dvisser-zz/Nissan-RB25DET-ECU/README.md

Nissan-RB25DET-ECU
==================

A drop in replacement PCB, designed to fit inside the factory ECU enclosure and use the factory wiring harness.
