dvisser-zz/Nissan-RB25DET-ECU/R33 RB25DET ECU Connector Pinout.pdf

R33 RB25DET ECU Pinout

Pin | Pin Function | Pin | Pin Function
| 1 IGN 1 | | 11 IGN 6
| 2 IGN 5 | | 12 IGN 2
| 3 IGN 3 | | 13 IGN 4
4 AAC Valve Control | 14
5 | 15
6 | 16 ECCS Relay
7 | 17
8 | 18 Fuel Pump Relay
| 9 A/C Relay | | 19 P/S Oil Pressure Switch
| 10 EARTH – IGN | | 20 EARTH – IGN
| 21 RX ( Diagnosis )* | | 31 CLK
| 22 TX ( Diagnosis )* | | 32 Engine Warning Lamp
23 | 33 Exhaust Temp Warning Lamp
24 | 34
25 Boost Control Solenoid | 35
| 26 AFM Signal Ground | | 36 FICD Relay
27 AFM Signal | 37
| 28 ECT Sensor Signal | | 38 TPS Signal
29 Oxygen Sensor Signal | 39
30 EARTH Sensor System | 40
| 41 CAS SYNC Signal | | 51 CAS SYNC Signal
42 CAS REF Signal | 52
| 43 Start Switch Signal | | 53 Vehicle Speed Sensor
44 Neutral Switch Signal* | 54
45 Ignition Switch Signal | 55
| 46 A/C Switch Signal | | 56 TPS Signal Out to A/T, HICAS
| 47 CHK ( Diagnosis )* | | 57 Exhaust Temp Sensor*
| 48 TPS Reference Voltage | | 58 Battery Power
| 49 C/U Power | | 59 C/U Power
| 50 C/U earth | | 60 C/U Earth
101 INJ 1 | 109 Inverse Current Feedback System
102 | | 110
103 INJ 3 | 111
104 Fuel Pump Speed Control | 112 INJ 6
105 INJ 2 | 113 VCT Solenoid
106 | 114 INJ 4
107 EARTH INJ System | 115 Oxygen Sensor Heater Ground
108 EARTH INJ System | 116 EARTH INJ System

* Not confirmed

Tacho Signal Out

Knock Sensor 1 ( Cyl 1-3 ) Knock Sensor 2 ( Cyl 4-6 )

INJ 5 (2nd)
