dvisser-zz/Nissan-RB25DET-ECU/76 Pin Connector 5-174385-5 .pdf

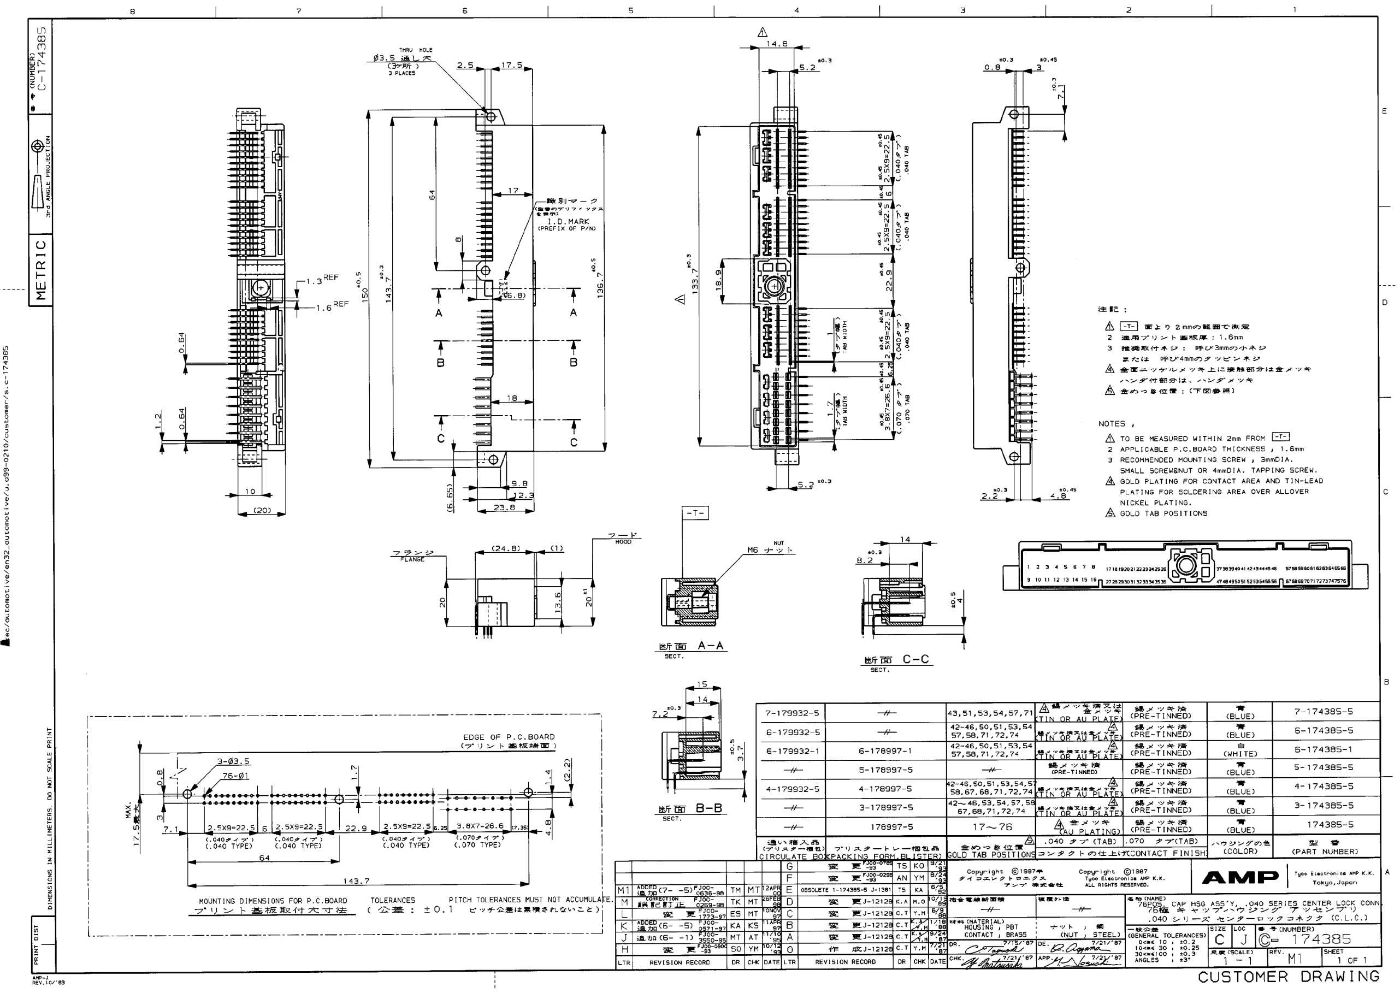
[picture p1: page 1]
