dvisser-zz/Nissan-RB25DET-ECU/Nissan-RB25DET-ECU-Connector.pdf

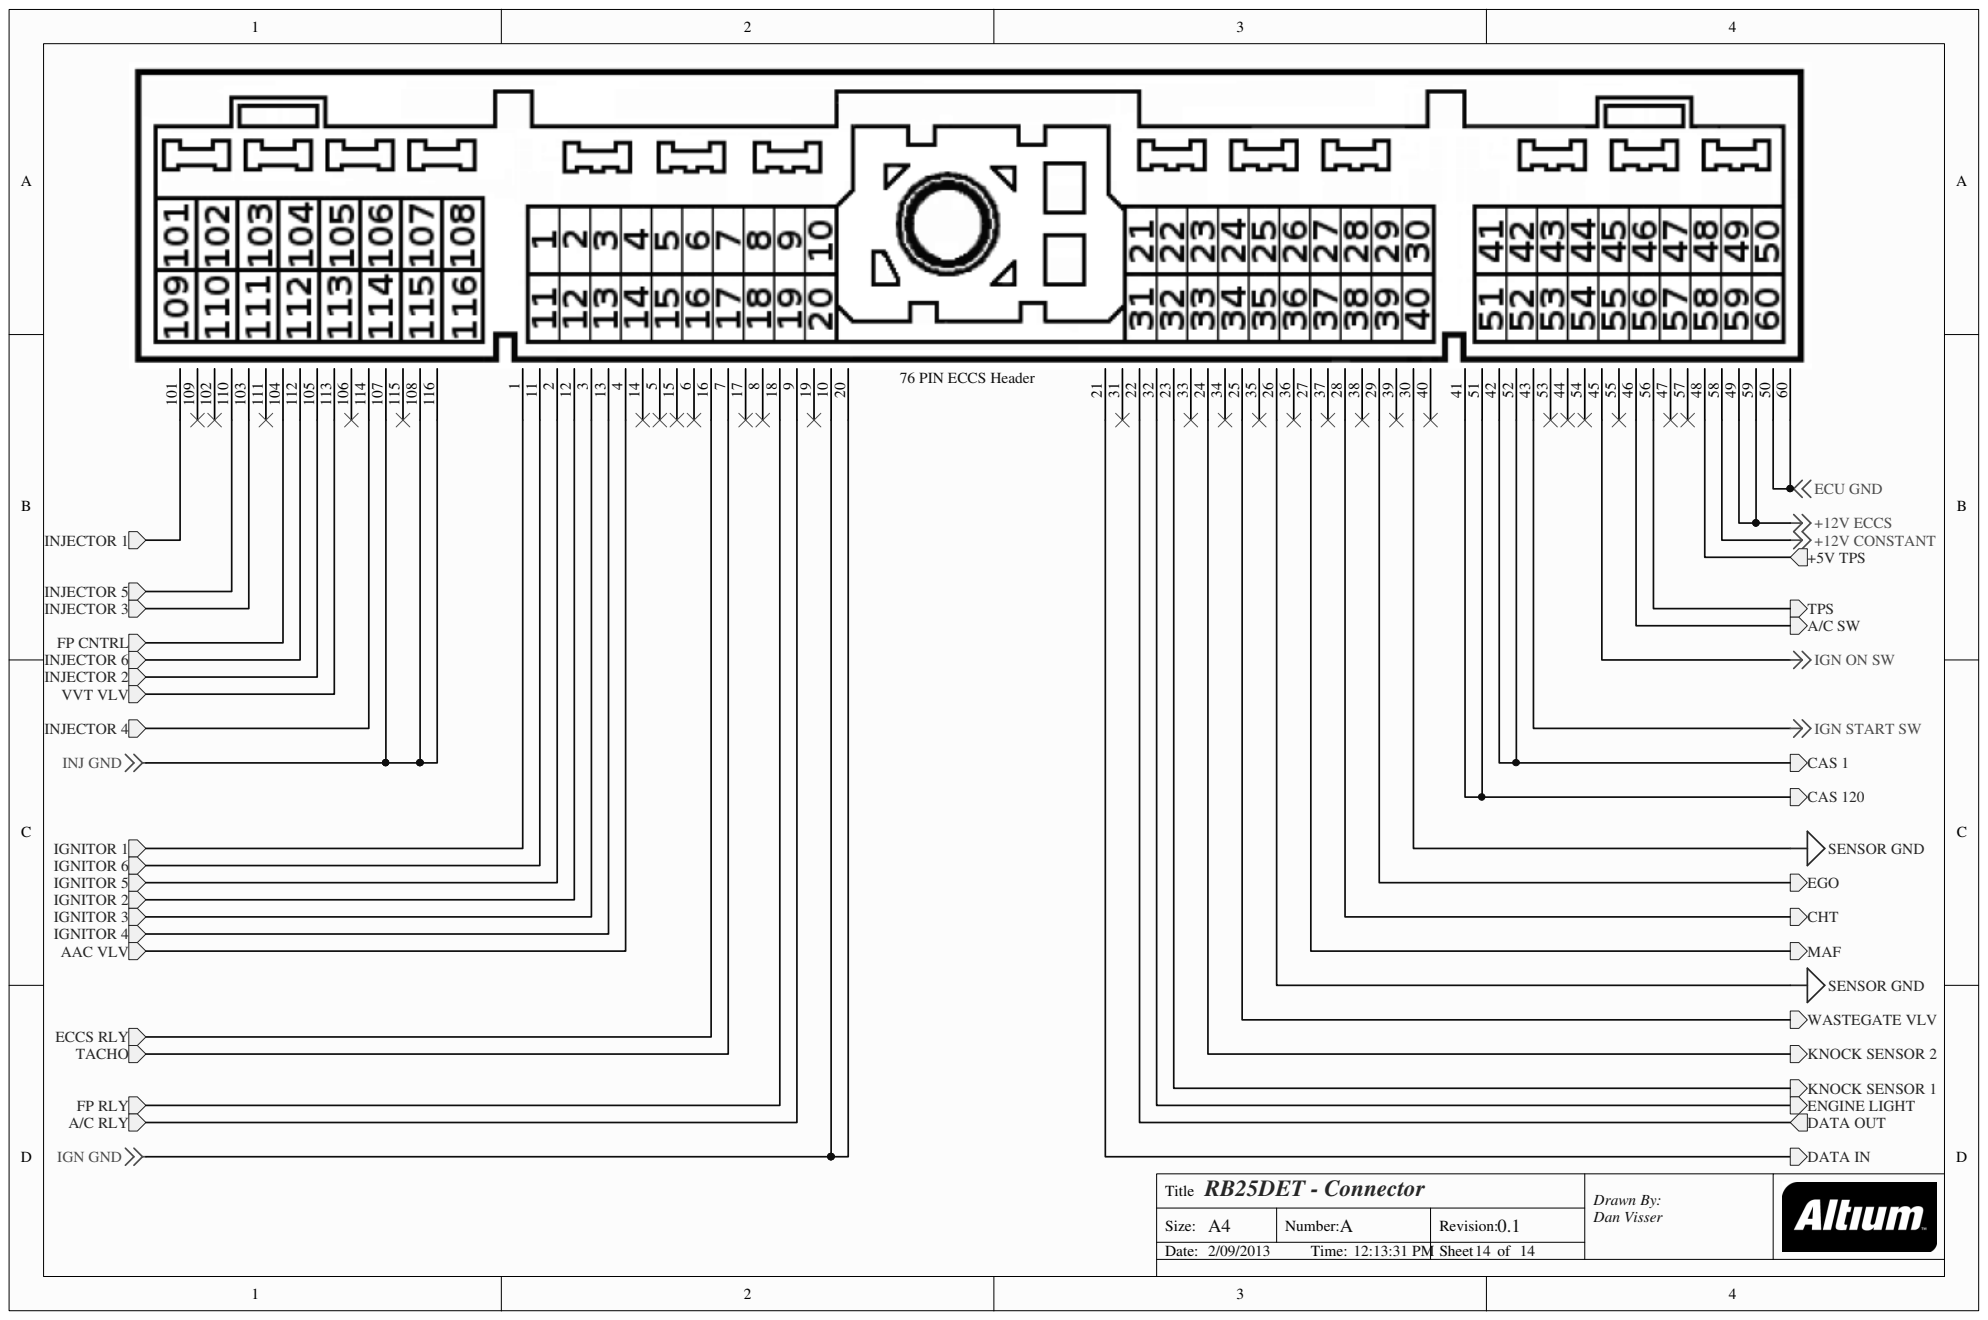
[picture p2: page 1]
Drawn By: Dan Visser; RB25DET - Connector; Title; Size:; Number:; Date:; Revision:; Time:; Sheet; +12V CONSTANT; +12V ECCS; ECU GND; INJ GND; INJECTOR 1; INJECTOR 2; INJECTOR 3; INJECTOR 4; INJECTOR 5; INJECTOR 6; FP RLY; IGNITOR 1; CHT; TPS; EGO; +5V TPS; IGNITOR 2; IGNITOR 3; IGNITOR 4; IGNITOR 5; IGNITOR 6; KNOCK SENSOR 1; SENSOR GND; IGN GND; DATA IN; DATA OUT; KNOCK SENSOR 2; WASTEGATE VLV; MAF; ENGINE LIGHT; VVT VLV; FP CNTRL; AAC VLV; ECCS RLY; TACHO; A/C RLY; CAS 120; CAS 1

76 PIN ECCS Header

IGN ON SW

IGN START SW
