dvisser-zz/Nissan-RB25DET-ECU/Nissan-RB25DET-ECU.pdf

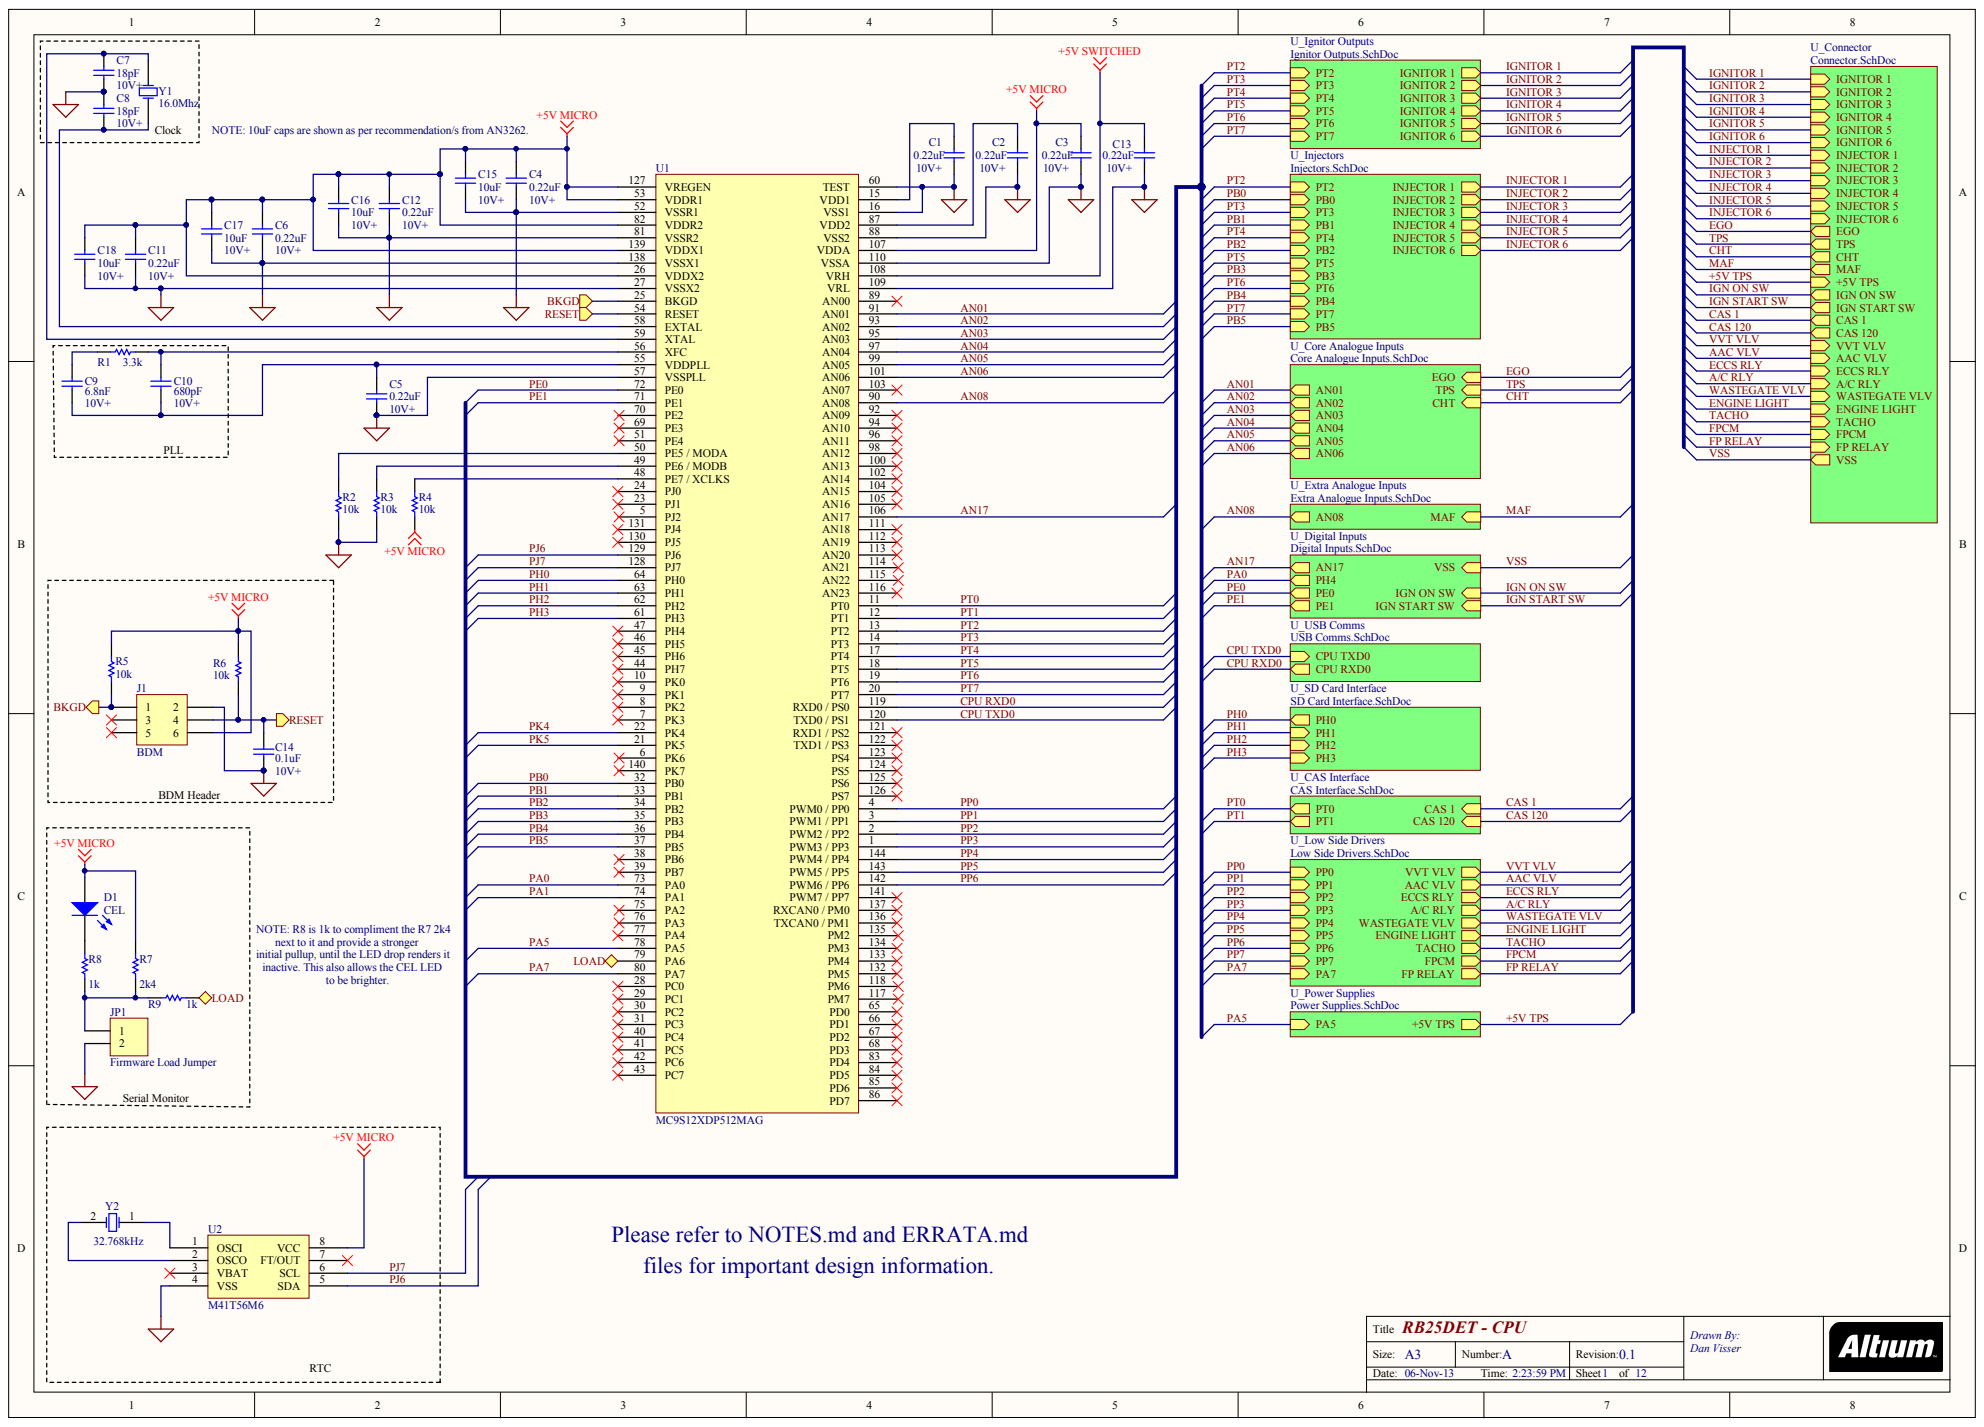
[picture p3: page 1]

IGNITOR 1 CHT TPS EGO
IGNITOR 1 CAS 1 CAS 120 CHT TPS EGO
IGNITOR 2
IGNITOR 3

5 2
8 2 | | 8 7

1 3 9 | 1 0 7
1 3 8 | | 1 1 0
2 6 | | 1 0 8

5 9
5 6 | U_ C ore An alo g u e Inp uts C ore An alo g u e Inp uts.S c hDo c
5 5

EGO TPS CHT CAS 1 CAS 1

WAS
TACHO ENGINE LIGHT FPCM

4 9 | | 1 0 0
4 8 | | 1 0 2

2 4 P J 6 | | 1 0 4 | U_ E xtra An alo g u e Inp uts E xtra An alo g u e Inp uts.S c hDo c

Please refer to NOTES.md and ERRATA.md
files for important design information.

Dr a w n By : Da n Vis s e r

A3 | er: | R e visio n :

Date : Time : | | S h e e t 1 o f 1 2

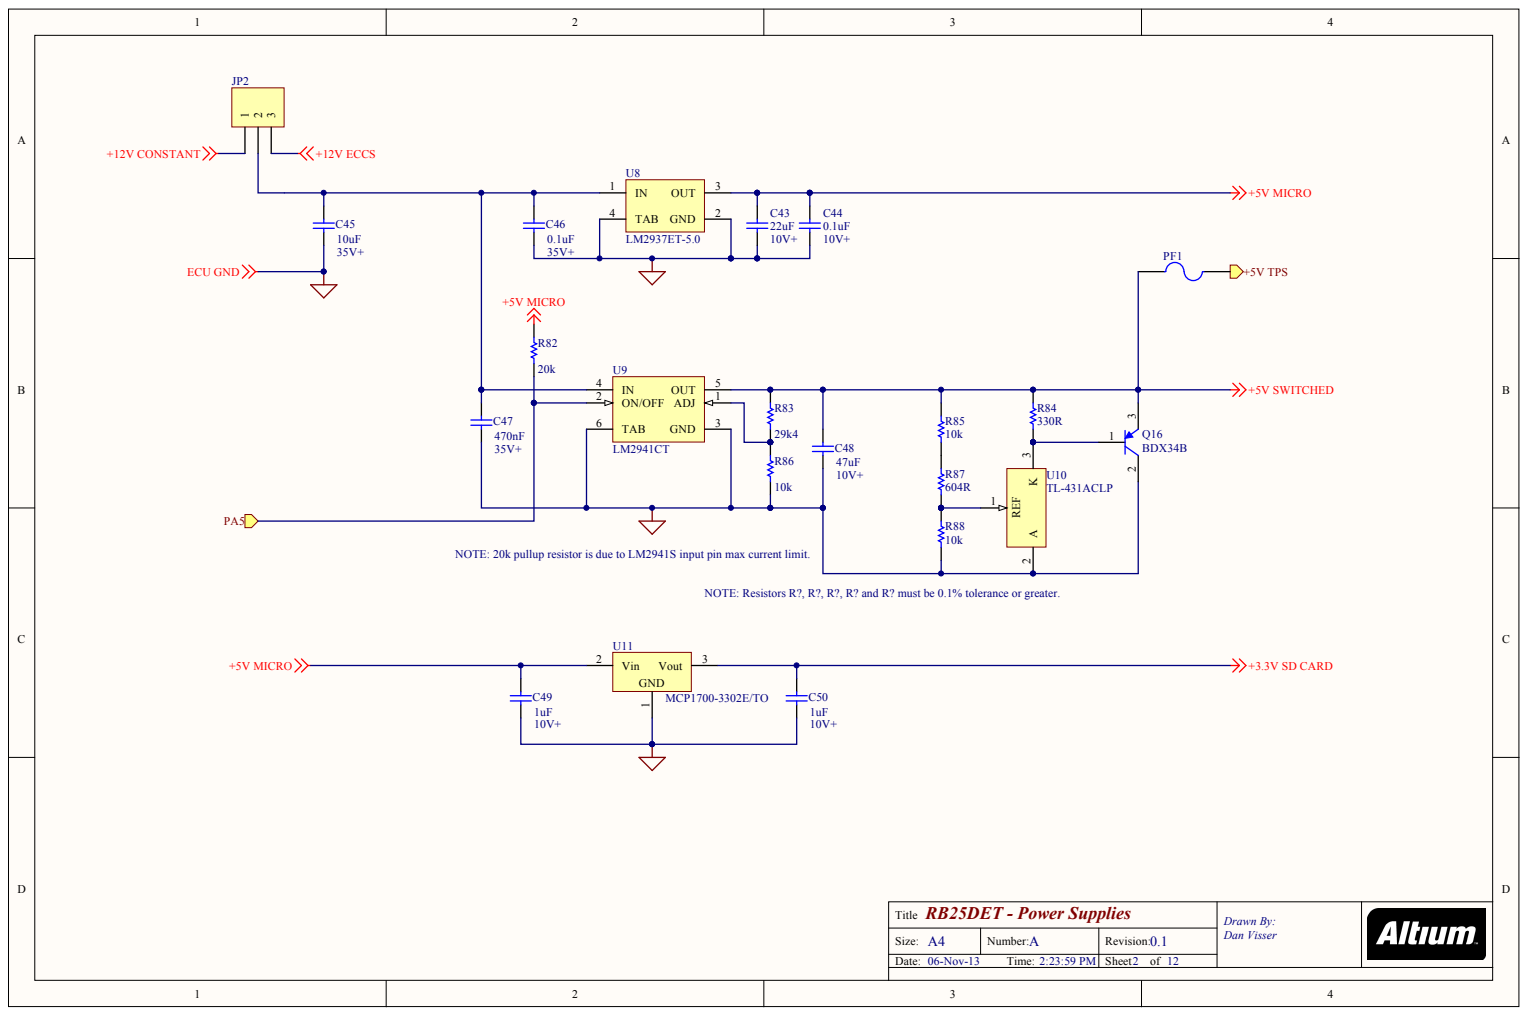
[picture p4: page 2]

p resistor is due to LM2

d R? must be 0.1% tolerance or greater.

Drawn By: Dan Visser

A4 | N umber: | Revisio n :
Date: Time: | | S heet 2 o f 1 2

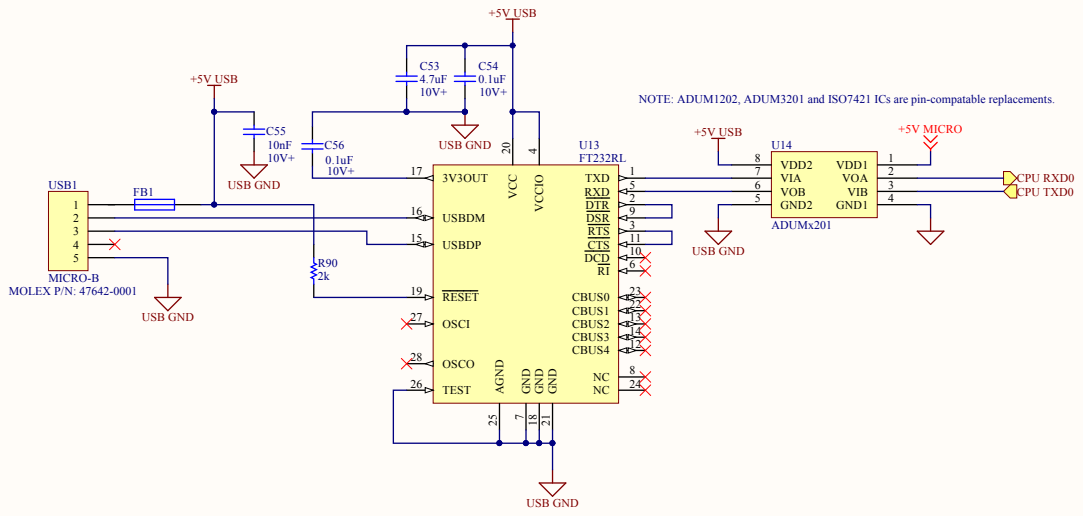
[picture p5: page 3]

1 ICs are pin-compatable replacements.

Drawn By: Dan Visser

A4 | N umber: | Revisio n :
Date: Time: | | S heet 3 o f 1 2

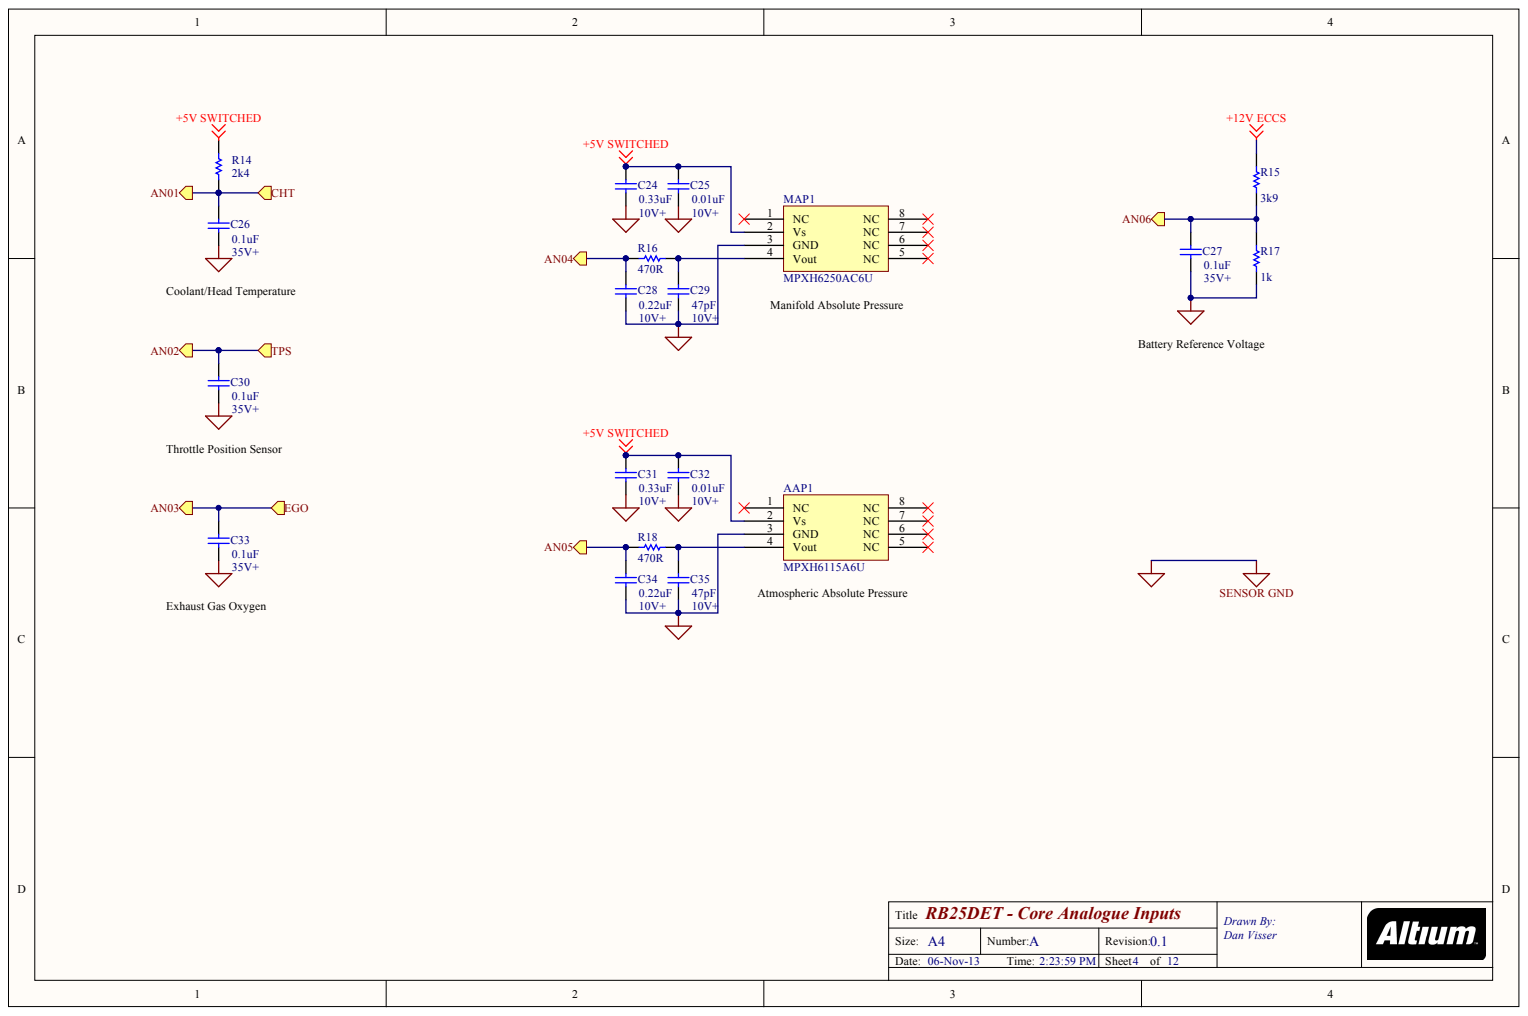
[picture p6: page 4]

Drawn By: Dan Visser

A4 | N umber: | Revisio n :
Date: Time: | | S heet 4 o f 1 2

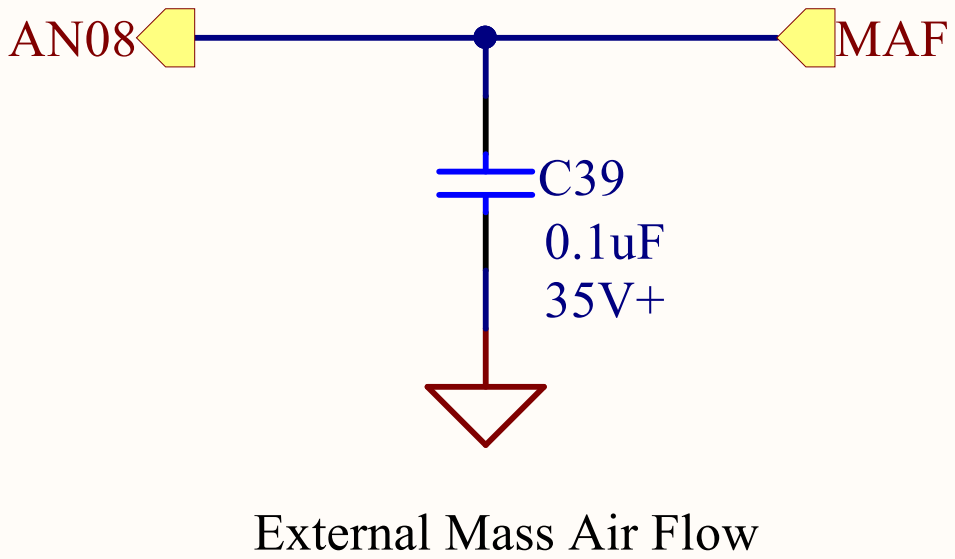
[picture p7: page 5]

External Mass Air Flo

Drawn By: Dan Visser

A4 | N umber: | Revisio n :
Date: Time: | | S heet 5 o f 1 2

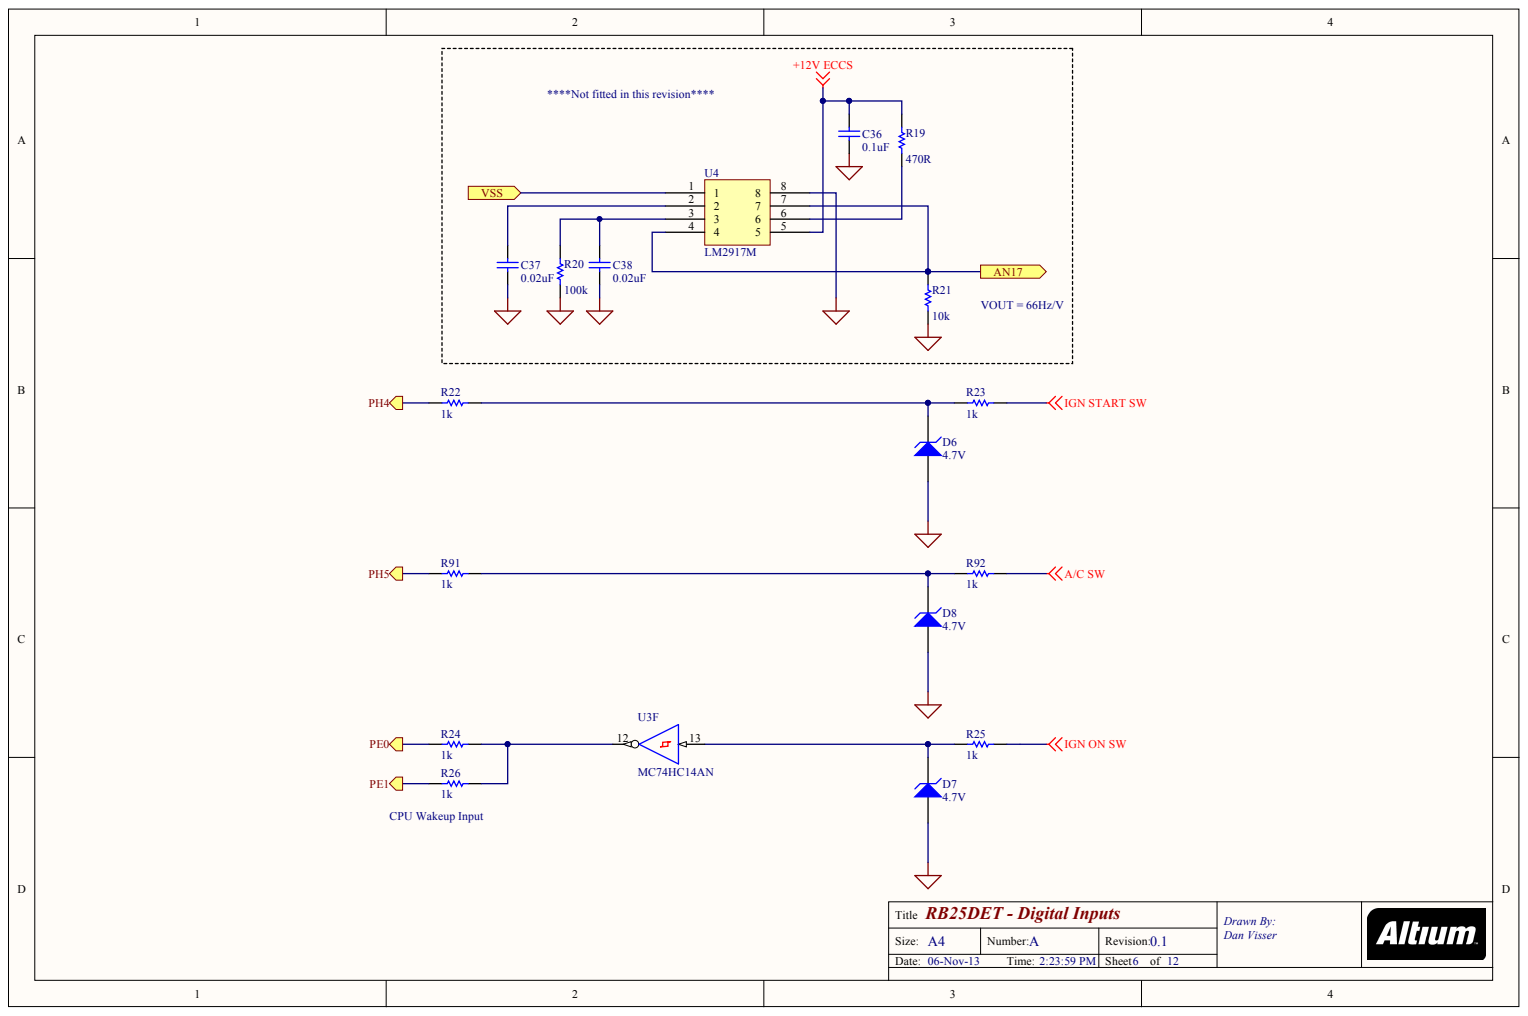
[picture p8: page 6]

****Not fitted in this revision****

Title RB25DET - Digital Inputs | Drawn By: Dan Visser

Size: A4 | Number: A | Revision: 0.1
Date: 06-Nov-13 Time: 2:23:59 PM | | Sheet 6 of 12

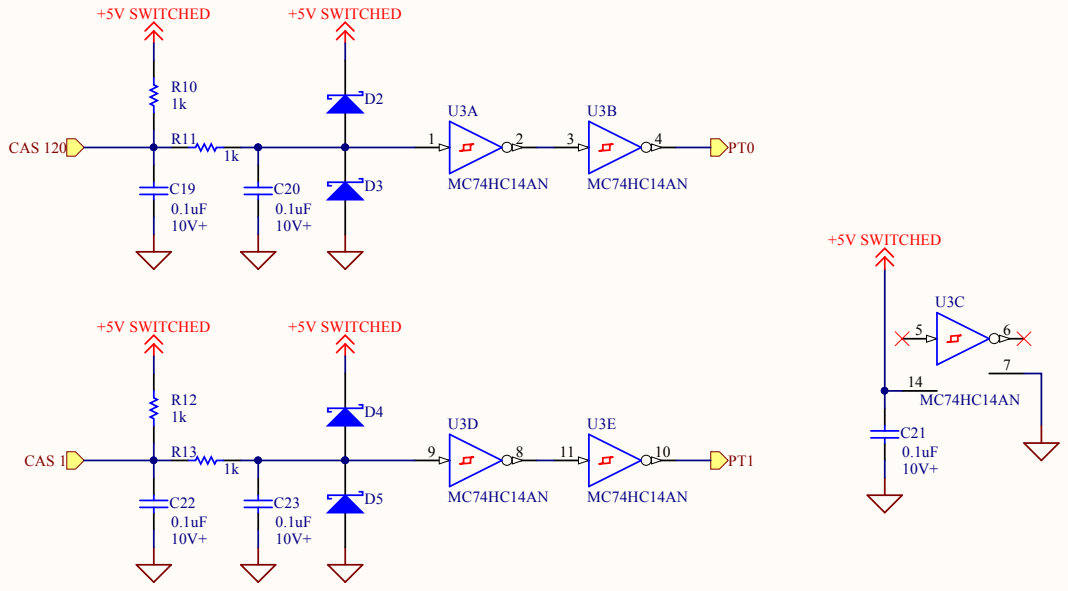
[picture p9: page 7]

Drawn By: Dan Visser

A4 | N umber: | Revisio n :
Date: Time: | | S heet 7 o f 1 2

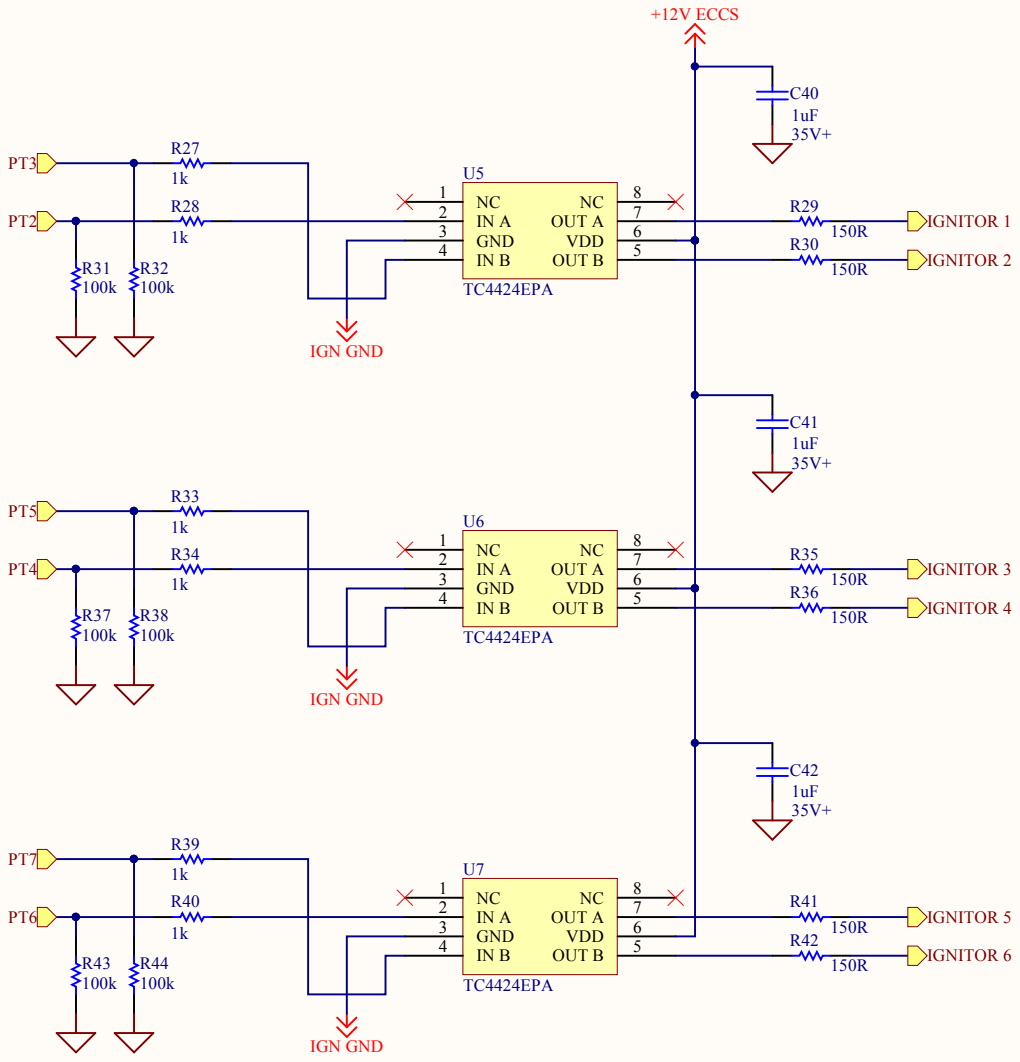
[picture p10: page 8]

Drawn By: Dan Visser

A4 | N umber: | Revisio n :
Date: Time: | | S heet 8 o f 1 2

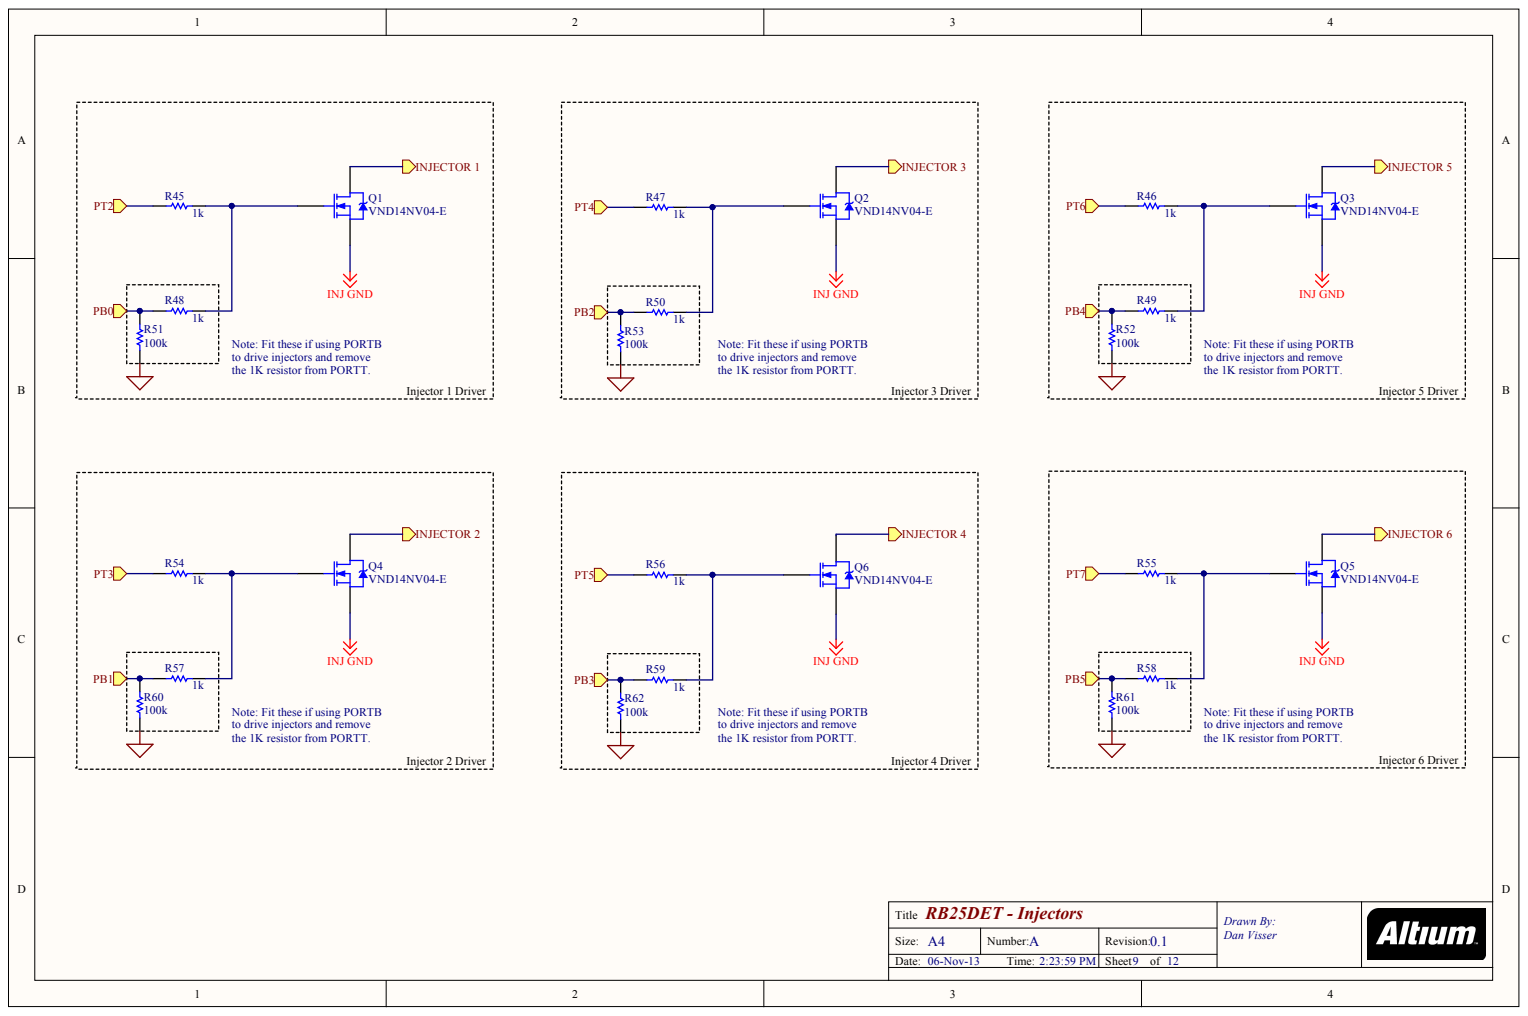
[picture p11: page 9]

ote: Fit these if usin
to drive injectors an
the 1

Drawn By: Dan Visser

A4 | N umber: | Revisio n :
Date: Time: | | S heet 9 o f 1 2

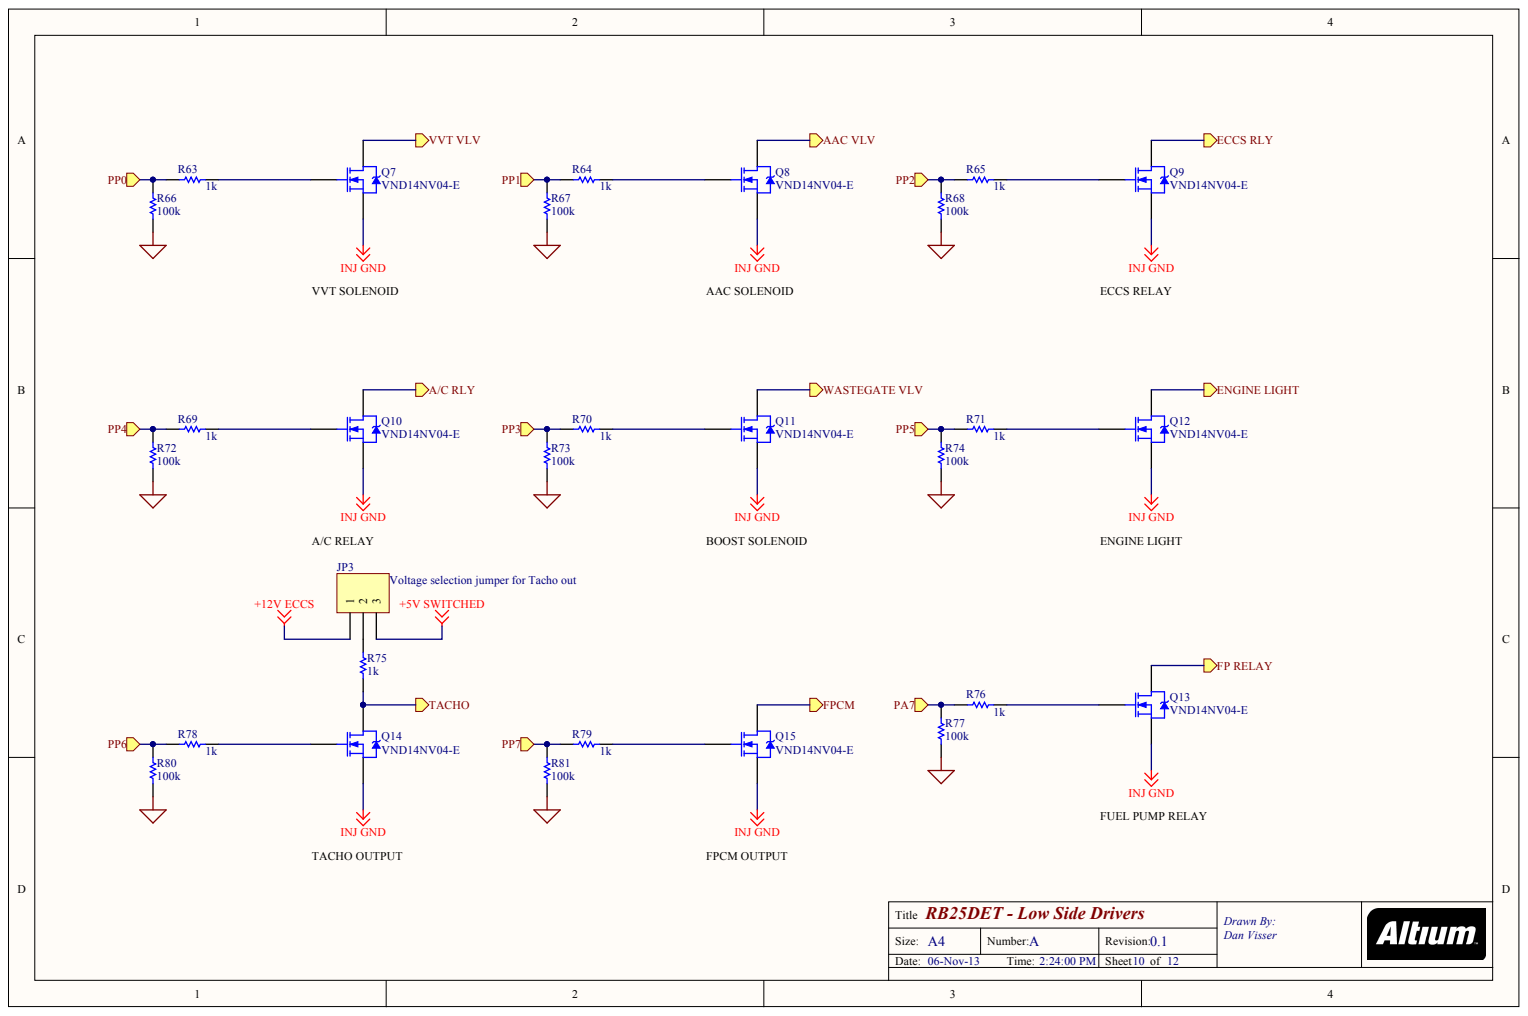
[picture p12: page 10]

Drawn By: Dan Visser

A4 | N umber: | Revisio n :
Date: Time: | | S heet 1 0 o f 1 2

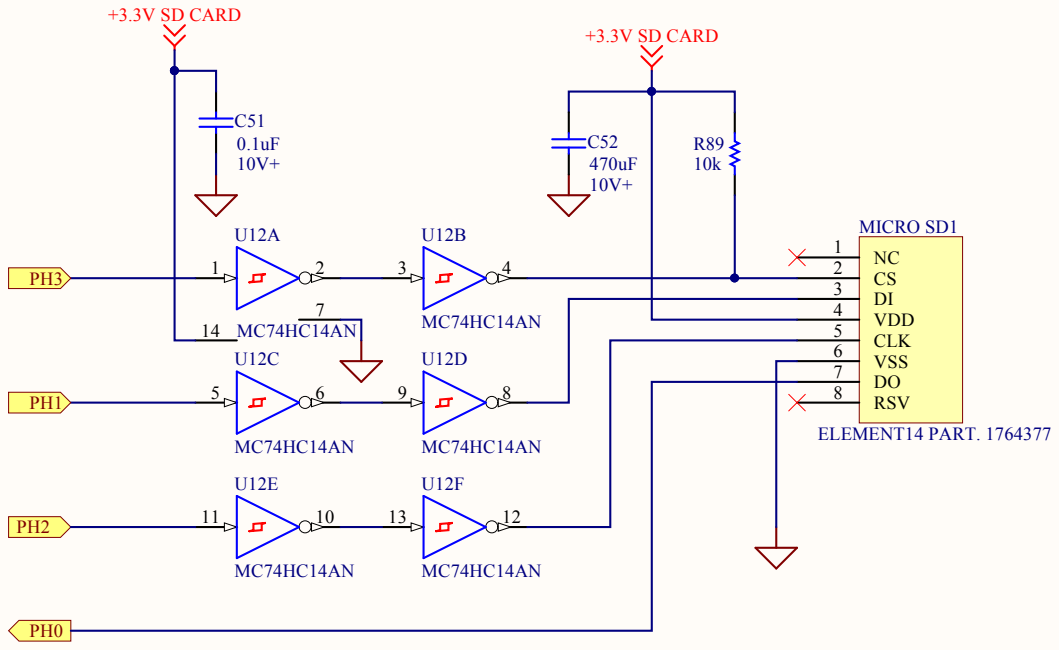
[picture p13: page 11]

VDD 4

VSS 6

MC74HC14AN | MC74HC14AN | | RSV 8

Title RB25DET - SD Card Interface | Drawn By: Dan Visser

Size: A4 | Number: A | Revision: 0.1
Date: 06-Nov-13 Time: 2:24:00 PM | | Sheet 11 of 12

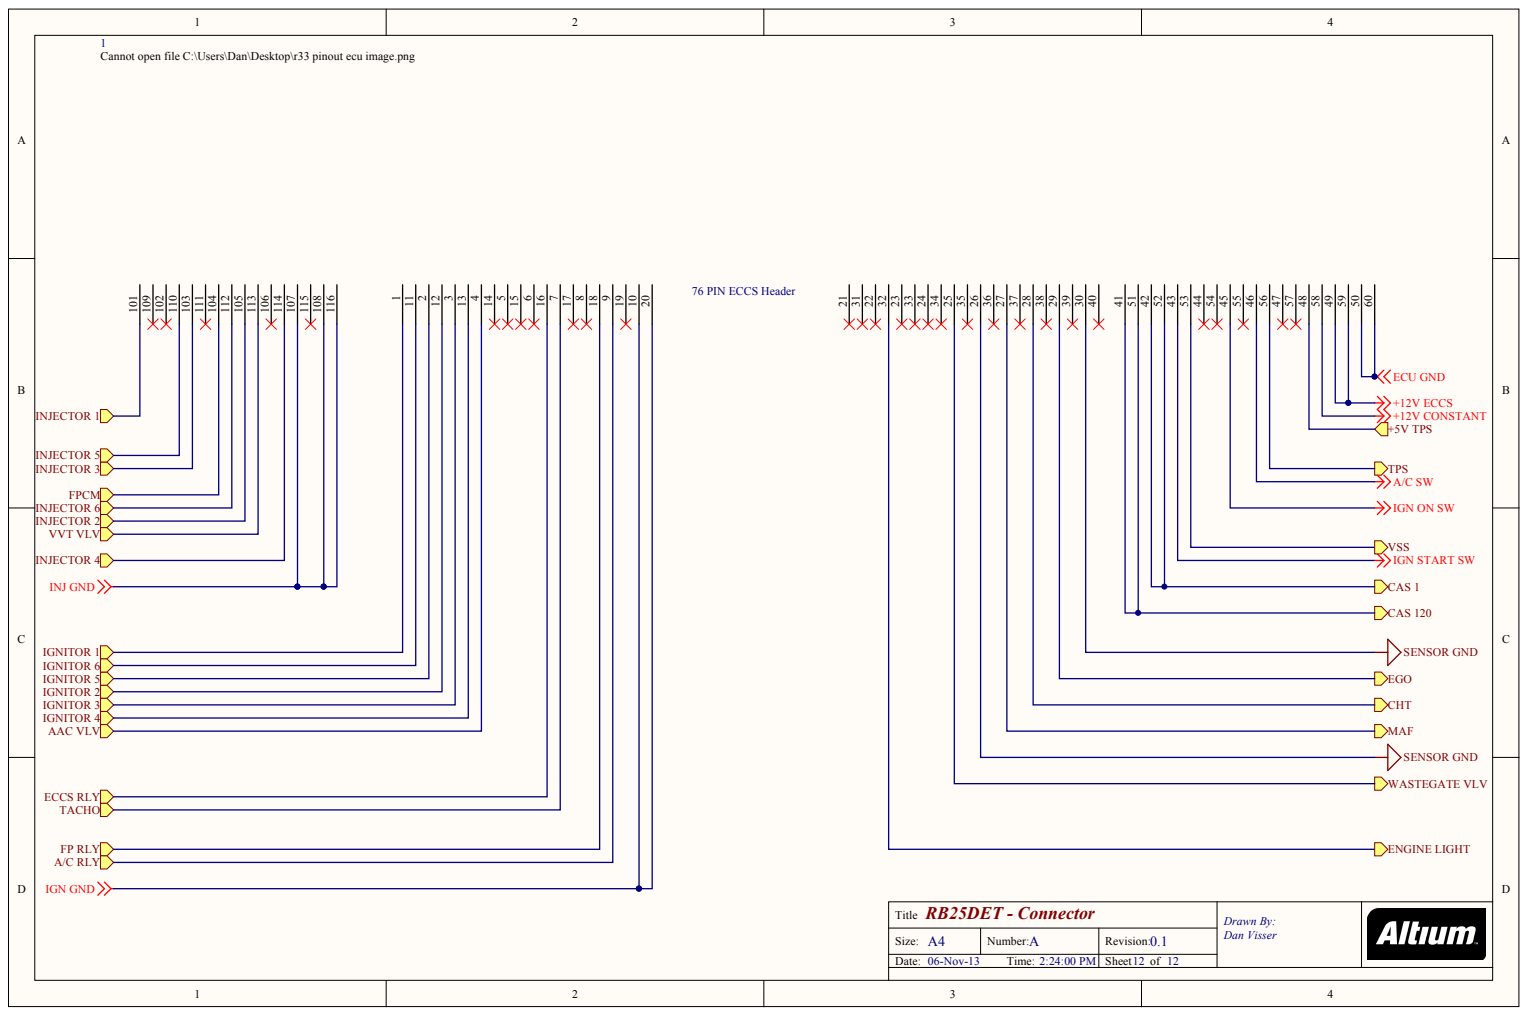
[picture p14: page 12]

Cannot open file C:\Users\Dan\Desktop\r33 pinout ecu image.png

Title RB25DET - Connector | Drawn By: Dan Visser

Size: A4 | Number: A | Revision: 0.1
Date: 06-Nov-13 Time: 2:24:00 PM | | Sheet 12 of 12

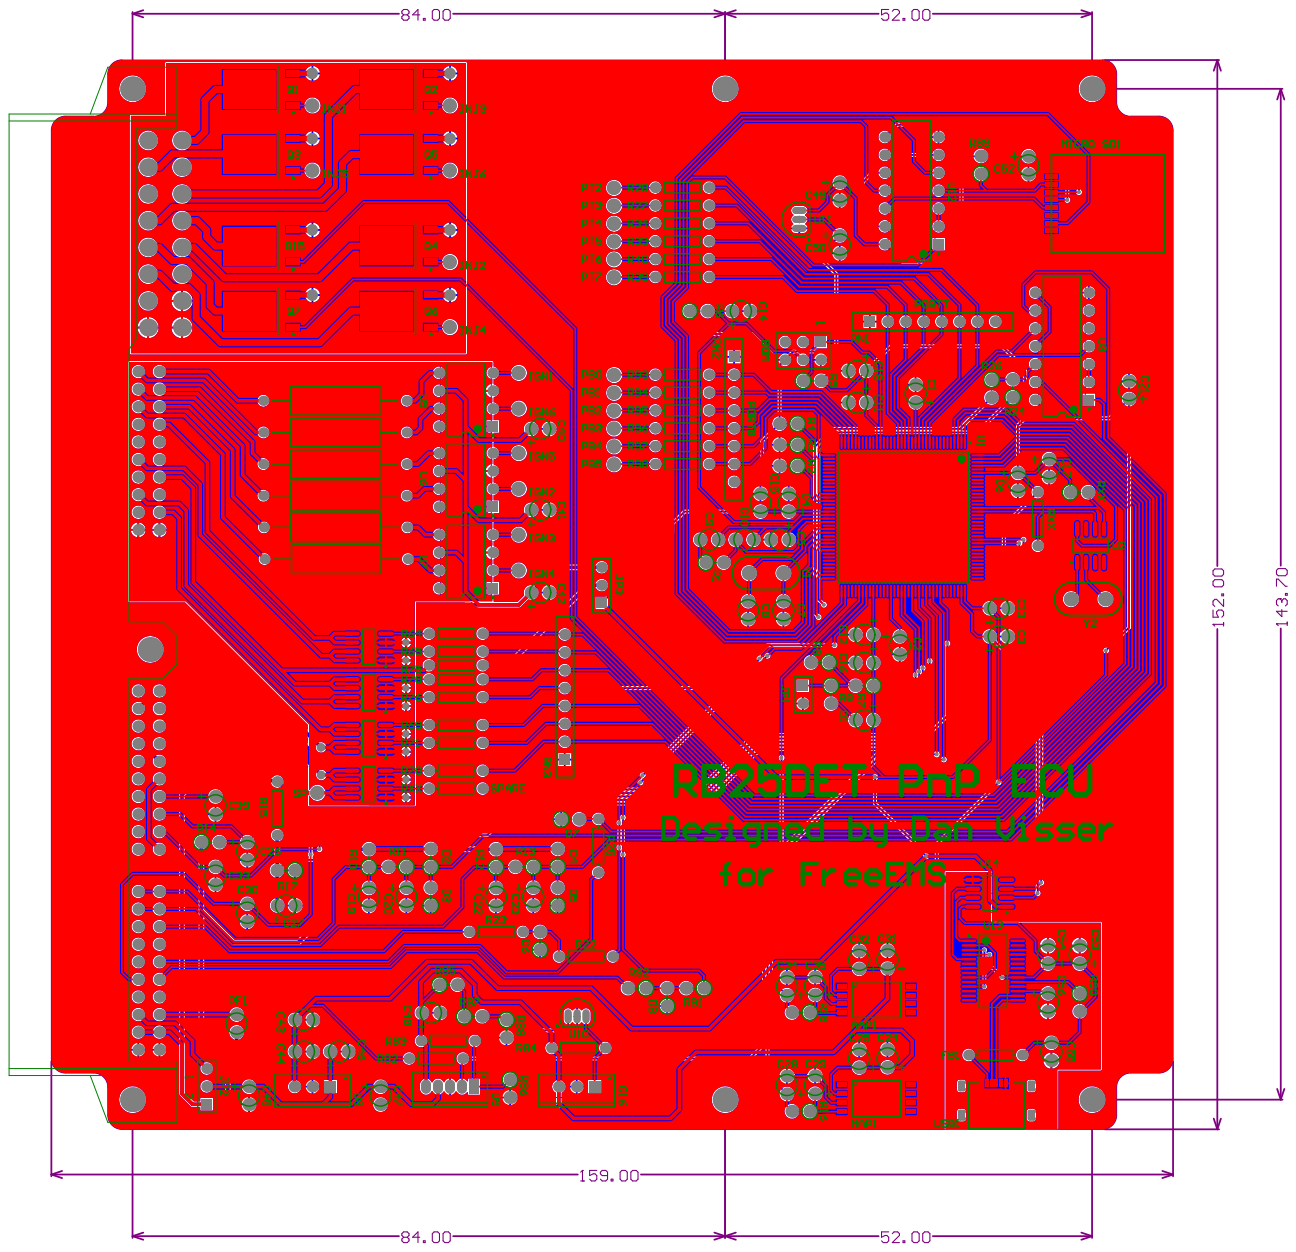
[picture p15: page 13]
