dvisser-zz/Nissan-RB25DET-ECU/(list of files, drawings)

Other design files:
3-Wire ISCV Driver.SchDoc
CAS Interface.SchDoc
Connector.SchDoc
Core Analogue Inputs.SchDoc
CPU.SchDoc
Digital Inputs.SchDoc
Extra Analogue Inputs.SchDoc
FreeEMS Footprint Library.PcbLib
FreeEMS Schematic Library.SchLib
Ignitor Outputs.SchDoc
Injectors.SchDoc
IO Expansion Header.SchDoc
Knock Sensing.SchDoc
Low Side Drivers.SchDoc
Nissan-RB25DET-ECU.PcbDoc
Nissan-RB25DET-ECU.PrjPcb
Power Supplies.SchDoc
RS232 Comms.SchDoc
SD Card Interface.SchDoc
USB Comms.SchDoc
