dvisser-zz/Nissan-RB25DET-ECU/(commit log)

2013-08-30 Initial commit. Migration of RavAGE schematics. Yet to be updated to suit R33 RB25DET ECU configuration.
    [3-Wire ISCV Driver.SchDoc, CPU.SchDoc, Connector.SchDoc, Core Analogue Inputs.SchDoc, Digital Inputs.SchDoc, Extra Analogue Inputs.SchDoc, FreeEMS Footprint Library.PcbLib, FreeEMS Schematic Library.SchLib]
2013-09-01 Added connector and R33 pinout information.
2013-09-01 Merger of RavAGE schematics over to Nissan RB25DET ECU started.
    [CAS Interface.SchDoc, CPU.SchDoc, Core Analogue Inputs.SchDoc, Digital Inputs.SchDoc, Extra Analogue Inputs.SchDoc, Ignitor Outputs.SchDoc, Injectors.SchDoc, Knock Sensing.SchDoc]
2013-09-01 Removed VR Interfaces sheet.
    [VR Interfaces.SchDoc]
2013-09-01 Added 76 pin ECCS Nissan header to footprint library. On-going.
    [FreeEMS Footprint Library.PcbLib]
2013-09-01 Converted AutoCAD drawing of OEM PCB dimensions to PDF for future reference.
2013-09-01 Added PCB artwork file to Altium project. Artwork file drawn up as per measured OEM PCB dimensions.
    [Nissan-RB25DET-ECU.PcbDoc, Nissan-RB25DET-ECU.PrjPcb]
2013-09-01 Completed 76 pin ECCS connector footprint added to library.
    [FreeEMS Footprint Library.PcbLib]
2013-09-01 Started PCB. Dimensional issues exist that will be corrected during the next push.
    [Nissan-RB25DET-ECU.PcbDoc, Nissan-RB25DET-ECU.PrjPcb]
2013-09-01 Corrected dimensional PCB size issue mentioned in last push.
    [Nissan-RB25DET-ECU.PcbDoc]
2013-09-01 Generation of PDF representation of Altium project files. Slight housekeeping.
    [CPU.SchDoc, Nissan-RB25DET-ECU.PrjPcb]
2013-09-02 Finished porting schematics over from RavAGE mainstream set. Removed redundant circuits, new circuits still yet to be drawn for CAS input, etc. Connector sheet revamped.
    [CAS Interface.SchDoc, CPU.SchDoc, Connector.SchDoc, Core Analogue Inputs.SchDoc, Digital Inputs.SchDoc, Extra Analogue Inputs.SchDoc, FreeEMS Schematic Library.SchLib, Ignitor Outputs.SchDoc]
2013-09-02 CAS Interface circuit completed. As per Nissan OEM setup.
    [CAS Interface.SchDoc]
2013-09-02 Cleaned up links to other sheets.
    [CPU.SchDoc]
2013-09-02 Changed regulators to through-hole components. Updated pin numbering to suit. Changed PNP clamp transistor to through-hole component and updated schematic accordingly.
    [Power Supplies.SchDoc]
2013-09-02 Removed CBUS IO header and LEDS.
    [USB Comms.SchDoc]
2013-09-02 Changed MAX232 IC to DIP16 variant.
    [RS232 Comms.SchDoc]
2013-09-02 Updated AAP sensor part number due to part availability.
    [Core Analogue Inputs.SchDoc]
2013-09-02 Changed Logic IC to use spare gate from CAS circuit.
    [Digital Inputs.SchDoc]
2013-09-02 Moved spare gate to digital input - wakeup circuit. Also showed logic gate supply connections.
    [CAS Interface.SchDoc]
2013-09-02 Changed TC4427 IC to TC4424 as per MrOnion's suggestion. Thank you Mr Onion! Also removed output leds and cleaned up schematic aesthetically.
    [Ignitor Outputs.SchDoc]
2013-09-02 Changed to through-hole FET's. Removed LED's.
    [Injectors.SchDoc]
2013-09-02 Changed to through-hole FETs. Removed LED. Changed ground connection to INJ GND.
    [Low Side Drivers.SchDoc]
2013-09-02 Used same logic IC as CAS circuit. Cleaned up schematic aesthetically.
    [SD Card Interface.SchDoc]
2013-09-02 Removed VSS input connection.
    [Connector.SchDoc]
2013-09-02 Made power connections to logic IC visible.
    [SD Card Interface.SchDoc]
2013-09-02 Altium doesn't like the connector image I added to the connector sheet when it is told to generate a PDF. Printing that sheet to PDF is my temporary solution.
2013-09-02 Changed TL-431 to TL-431ACLP TO92 packaged part and updated pinout to suit.
    [Power Supplies.SchDoc]
2013-09-02 Removed AC switch signal.
    [Connector.SchDoc]
2013-09-02 Worked on wakeup circuit and addition of low side drives for relays/solenoids, etc.
    [CPU.SchDoc, Core Analogue Inputs.SchDoc, Digital Inputs.SchDoc, Extra Analogue Inputs.SchDoc, Low Side Drivers.SchDoc]
2013-09-02 Added circuits for TACHO output and ENGINE LIGHT control.
    [CPU.SchDoc, Low Side Drivers.SchDoc]
2013-09-02 Changed label for pin 104 to FPCM.
    [Connector.SchDoc]
2013-09-02 Added FPCM LSD.
    [CPU.SchDoc, Low Side Drivers.SchDoc]
2013-09-02 Added missing items to connector sheet link box.
    [CPU.SchDoc]
2013-09-02 Changed CPU pins assigned to digital inputs.
    [CPU.SchDoc, Digital Inputs.SchDoc]
2013-09-02 Updated PDF and correct text label on digital input sheet.
    [Digital Inputs.SchDoc]
2013-09-04 Added VSS input to CPU, via F/V IC.
    [CPU.SchDoc, Connector.SchDoc, Digital Inputs.SchDoc, FreeEMS Schematic Library.SchLib]
2013-09-04 Updated PDF. Altium housekeeping of PCB project file.
    [Nissan-RB25DET-ECU.PrjPcb]
2013-09-07 Added jumper to allow for key-switched-on or always-on mode of operation to support future firmware revisions. Also correct error in on/off pin control that allowed 12V to be sinked by the CPU instea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
    [Power Supplies.SchDoc]
2013-09-07 Moved boost solenoid to hi-res pwm pin. Swapped it with the a/c relay drive pin.
    [Low Side Drivers.SchDoc]
2013-09-07 Grounded driver IC's via IGN GND ecu connector pin to allow the use of ign ground lift monitor analog input circuit correctly.
    [Ignitor Outputs.SchDoc]
2013-09-07 Corrected text label on engine light drive circuit. Added jumpers for tacho output voltage selection and eccs relay switching to support different power philosophies.
    [Low Side Drivers.SchDoc]
2013-09-07 Schematics annotated.
    [CAS Interface.SchDoc, Core Analogue Inputs.SchDoc, Digital Inputs.SchDoc, Extra Analogue Inputs.SchDoc, Ignitor Outputs.SchDoc, Injectors.SchDoc, Knock Sensing.SchDoc, Low Side Drivers.SchDoc]
2013-09-07 PDF updated after schematics annotated.
    [Nissan-RB25DET-ECU.PcbDoc, Nissan-RB25DET-ECU.PrjPcb]
2013-09-07 Added 2.54mm through-hole resistor and capacitor footprints.
    [FreeEMS Footprint Library.PcbLib]
2013-09-07 The beginning of the PCB....
    [Nissan-RB25DET-ECU.PcbDoc]
2013-09-07 CPU decouple caps, pll, clk and some io circuits laid out. Updated footprint library. Updated PDF.
    [FreeEMS Footprint Library.PcbLib, Nissan-RB25DET-ECU.PcbDoc, Nissan-RB25DET-ECU.PrjPcb]
2013-09-08 Started routing INJ, IGN and CAS circuits. Added configurability for semi-seq, wasted-spark OR full fequential everything to support future firmware releases.
    [Nissan-RB25DET-ECU.PcbDoc]
2013-09-08 Altered CAS PORTT CPU pins to put correct signal to pulse accumulator.
    [CAS Interface.SchDoc]
2013-09-08 Updated/Added dimensional information.
    [Nissan-RB25DET-ECU.PcbDoc]
2013-09-08 Changed FET's back to SMD.
    [Injectors.SchDoc, Low Side Drivers.SchDoc]
2013-09-08 Minimal routing.
    [Nissan-RB25DET-ECU.PcbDoc]
2013-09-08 Updated PDF.
    [Nissan-RB25DET-ECU.PrjPcb]
2013-09-08 Changed analog CPU pin assignment for VSS F/V conv IC.
    [CPU.SchDoc, Digital Inputs.SchDoc]
2013-09-09 More routing work done on INJ and LSD circuits. Fet 'farm' created LOL.
    [FreeEMS Footprint Library.PcbLib, Nissan-RB25DET-ECU.PcbDoc]
2013-09-09 IGN circuits laid out. Updated PDF. Lots of work done at 'work' today LOL.
    [Nissan-RB25DET-ECU.PcbDoc]
2013-10-14 Worked on LSD's and method of switching from PORTT to PORTB.
    [Nissan-RB25DET-ECU.PcbDoc]
2013-10-14 Routed out signals for LSD's and some analogs. More work whilst at work lol
    [Nissan-RB25DET-ECU.PcbDoc]
2013-10-15 Worked on polygon pours and some more LSD placement.
    [Nissan-RB25DET-ECU.PcbDoc]
2013-10-21 PWR supply routing, analog routing, comms routing, lots of routing.....
    [Nissan-RB25DET-ECU.PcbDoc]
2013-10-30 More work at work.
    [CAS Interface.SchDoc, CPU.SchDoc, Connector.SchDoc, Core Analogue Inputs.SchDoc, Digital Inputs.SchDoc, Extra Analogue Inputs.SchDoc, Ignitor Outputs.SchDoc, Injectors.SchDoc]
2013-10-30 More work at work again.
    [Nissan-RB25DET-ECU.PcbDoc]
2013-11-03 Re-annotation of schematics. PCB work very close to completion.
    [CAS Interface.SchDoc, Connector.SchDoc, Core Analogue Inputs.SchDoc, Digital Inputs.SchDoc, Extra Analogue Inputs.SchDoc, Ignitor Outputs.SchDoc, Injectors.SchDoc, Low Side Drivers.SchDoc]
2013-11-04 Completed routing of analog signals.
    [Nissan-RB25DET-ECU.PcbDoc, Nissan-RB25DET-ECU.PrjPcb]
2013-11-04 Updated connector sheet for addition of ac switch input. Lots of routing completed. Only SD card and 5v routing remaining. Very very close.
    [CPU.SchDoc, Connector.SchDoc, Digital Inputs.SchDoc, Nissan-RB25DET-ECU.PcbDoc]
2013-11-04 All routing, except power rails, completed.
    [FreeEMS Footprint Library.PcbLib, Nissan-RB25DET-ECU.PcbDoc]
2013-11-04 SPIN 1 artwork COMPLETEDgit add .git add .
    [Nissan-RB25DET-ECU.PcbDoc, Nissan-RB25DET-ECU.PrjPcb]
2013-11-06 Minimal adjustment to via and USB shield pad diameters as per request from PCB manufacturer.
    [Nissan-RB25DET-ECU.PcbDoc, Nissan-RB25DET-ECU.PrjPcb]
2013-11-06 whoops... I missed 4 via diameter changes as per pcb manufacturer request, these are now done and file is ready for manufacture.
    [Nissan-RB25DET-ECU.PcbDoc]
